SzymonWarmiak/uec_projekt_wireless_camera_transfer/doc/raport_warmiak_twardosz_2026.docx

# Tytuł: Bezprzewodowy System Transmisji Wideo i Sterowania

# Autorzy: Szymon Warmiak (SW), Grzegorz Twardosz (GT)

Ostatnia modyfikacja: 12.06.2026

Spis treści

1. Repozytorium git 1

2. Wstęp 1

3. Specyfikacja 1

3.1. Opis ogólny algorytmu 1

3.2. Tabela zdarzeń 2

4. Architektura 2

4.1. Moduł: top 2

4.1.1. Schemat blokowy 2

4.1.2. Porty 3

a) mou – mouse_ctl, input 3

b) vga – vga_ctl, output 3

4.1.3. Interfejsy 3

a) m2c – mouse_ctl to core 3

4.2. Rozprowadzenie sygnału zegara 3

5. Implementacja 4

5.1. Lista zignorowanych ostrzeżeń Vivado. 4

5.2. Wykorzystanie zasobów 4

5.3. Marginesy czasowe 4

6. Film. 4

# 1. Repozytorium git

Adres repozytorium GITa:

https://github.com/SzymonWarmiak/FPGA-Wireless-Rover

# 2. Wstęp

Celem tego projektu było wykonanie zdalnie sterowanej mobilnej platformy jeżdżącej wyposażonej w kamerę OV7670 która przesyła odebrany obraz z powrotem do stacji bazowe z wyjściem VGA.
Pomysł zrodził się z chęci połączenia zagadnień przetwarzania obrazu w czasie rzeczywistym na FPGA z komunikacją bezprzewodową Wi-Fi. System wykorzystuje dwie płytki Basys 3 połączone radiowo przez mikrokontrolery ESP32, realizując transmisję obrazu z kamery OV7670 w rozdzielczości 320×240 pikseli w skali szarości. Dodatkowo zaimplementowano zdalne sterowanie platformą jezdną (mostek H L298N) z dedykowanej aplikacji mobilnej (Android) oraz desktopowej (Windows/Python).

# 3. Specyfikacja

## 3.1. Opis ogólny algorytmu

## 1. Po włączeniu zasilania moduł MMCME2_BASE generuje zegary 40 MHz (system) i 65 MHz (VGA)..

## 2. Konfigurator (ov7670_configurator) programuje 55 rejestrów kamery OV7670.

## 3. Moduł ov7670_capture przechwytuje klatki RGB565, wyciąga luminancję (kanał zielony), wykonuje downsampling 2× do rozdzielczości 320×240 i generuje strumień AXI-Stream.

## 4. Piksele przechodzą przez asynchroniczne FIFO z domeny pclk kamery do domeny systemowej 40 MHz.

## 5. Maszyna stanów (WAIT_FRAME → SEND_PIXELS → SEND_CTRL) w top.sv kieruje strumień do modułu spi_stream_master, który wysyła 76 800 bajtów przez SPI z zegarem 20 MHz do ESP32.

## 6. ESP32 (cam) fragmentuje klatkę na 75 pakietów UDP po 1027 B i transmituje bezprzewodowo do ESP32 (station).

## 7. ESP32 (station) składa pakiety i udostępnia je przez SPI slave.

## 8. FPGA stacji (spi_stream_rx) odpytuje ESP32 wysyłając marker 0xCAFE i odbiera 76 800 B klatki, zapisując ją do dual-port BRAM.

## 9. Renderer VGA (vga_frame_renderer) odczytuje BRAM i wykonuje obrót o 90° oraz skalowanie ×2.13, wyświetlając obraz w standardzie XGA 1024×768 @ 60 Hz.

- Komendy sterujące (4-bitowy nibble) wysyłane z aplikacji mobilnej (Android/Windows)

przez UDP do ESP32 (cam), który przekazuje je po SPI MISO z powrotem do FPGA kamery.

Moduł motor_l298n_decode dekoduje nibble na sygnały IN1-IN4 mostka H silników L298N.

## 3.2. Tabela zdarzeń

Opis zdarzeń występujących podczas działania programu/urządzenia, zarówno zewnętrznych (interakcje z użytkownikiem), jak i wewnętrznych (specyficzne stany w algorytmie). Zdarzenia podzielone są na kategorie dotyczące różnych stanów działania programu. Kategorie powinny odpowiadać stanom ze schematu z pkt. 2.1.

Zdarzenie | Kategoria | Reakcja systemu
Naciśnięcie btnC | Reset | Asynchroniczny reset wszystkich modułów
Koniec konfiguracji SCCB | Inicjalizacja | Kamera generuje klatki (done=1)
vsync z kamery | Przechwytywanie | Zerowanie liczników, ustawienie flagi SOF
fifo_tuser=1 (SOF) | Transmisja | FSM przechodzi z WAIT_FRAME do SEND_PIXELS
spi_tlast=1 | Transmisja | Koniec klatki SPI, FSM wraca do WAIT_FRAME
Marker 0xCAFE odebrany | Odbiór (station) | ESP32 potwierdza połączenie, wysyła klatkę
Komenda UDP z aplikacji | Sterowanie | Nibble przekazywany do motor_l298n_decode
Sprzeczne komendy (góra+dół) | Sterowanie | motor_l298n_decode wymusza MOT_STOP

# 4. Architektura

Uwaga: dobrze zrobiony projekt zawiera tylko moduły strukturalne (zbudowane z innych modułów) i funkcjonalne (zawierające bloki proceduralne always @). Staramy się nie generować bloków mieszających te dwa typy, o ile to możliwe (głównym kryterium powinna być czytelność kodu).

Uwaga: opisujemy architekturę tylko głównego modułu oraz rozprowadzenie sygnału zegara.

## 4.1. Moduł: top

Osoba odpowiedzialna: JK

### 4.1.1. Schemat blokowy

Uwaga: Schemat blokowy to nie jest schemat z Vivado! Nie zawiera on sygnałów, tylko interfejsy. Interfejs oznacza tutaj grupę sygnałów. Schemat blokowy pokazuje moduły składowe, oraz łączące je interfejsy.

Miejsce na schemat blokowy modułu głównego

Uwaga:

- interfejsy dwukierunkowe rozbijamy na 2 interfejsy jednokierunkowe
- nazwa interfejsu stanowi prefiks nazwy sygnałów składowych
- w interfejsach nie uwzględniamy sygnałów globalnych (np. clk i rst).

### 4.1.2. Porty

#### a) mou – mouse_ctl, input

nazwa portu | opis
mou_si | szeregowe wejście danych

#### b) vga – vga_ctl, output

nazwa portu | opis
vga_vs | sygnał synchronizacji pionowej VGA

### 4.1.3. Interfejsy

#### a) m2c – mouse_ctl to core

nazwa sygnału | opis
m2c_x[9:0] | horyzontalna pozycja kursora myszy na ekranie
m2c_y[9:0] | wertykalna pozycja kursora myszy na ekranie

## 4.2. Rozprowadzenie sygnału zegara

Osoba odpowiedzialna: JK

Informacja na temat źródła sygnału zegarowego, używanych częstotliwości zegara w całym układzie.

Moduł generatora zegara umieszczamy w module głównym projektu. W pozostałych modułach używamy tylko i wyłącznie sygnały zegara wygenerowane przez ten moduł.

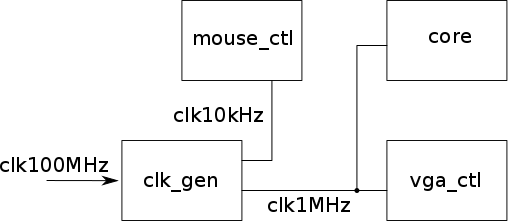
[picture p10: figure]

Uwaga: jeżeli używamy różnych częstotliwości zegara w układzie, to należy je tak dobrać, aby były wielokrotnościami siebie (umożliwia to wygenerowanie tych sygnałów z jednego IP core generatora zegara i zapobiega problemom z synchronizacją).

# 5. Implementacja

## 5.1. Lista zignorowanych ostrzeżeń Vivado.

Identyfikator ostrzeżenia | Liczba wystąpień | Uzasadnienie

## 5.2. Wykorzystanie zasobów

Tabela z wykorzystaniem zasobów z Vivado

## 5.3. Marginesy czasowe

Marginesy czasowe (WNS) dla setup i hold.

# 6. Konfiguracja sprzętu

Schemat połączenia ze sobą płytek Basys3 w trybie multiplayer.

Schematy podłączenia dodatkowych urządzeń peryferyjnych.

Konfiguracja zworek, przełączników, itp., jeśli inna niż domyślna.

# 7. Film.

Link do ściągnięcia filmu:

https://

MTM UEC2 12.06.2026 Raport z projektu, v.1.0.1 4 / 4
