SzymonWarmiak/uec_projekt_wireless_camera_transfer/tools/README.md

# Narzędzia projektowe (Tools)

Ten folder zawiera uniwersalne skrypty wspierające pracę z wieloma układami w projekcie (w tym automatyzację wgrywania kodu na konkretne płytki FPGA).

## 1. Wgrywanie Bitstreamu na FPGA (`program_basys.sh`)

Skrypt `program_basys.sh` pozwala na wgranie wygenerowanego strumienia bitów (`.bit`) na docelową płytkę Basys 3. Skrypt został zintegrowany z plikiem konfiguracyjnym, dzięki czemu nie trzeba pamiętać długich sprzętowych numerów JTAG.
Po wgraniu `.bit` skrypt programuje też lokalną pamięć QSPI plikiem `.bin`, dzięki czemu FPGA odtworzy konfigurację po ponownym włączeniu zasilania.

### Jak tego używać?
Będąc w **głównym katalogu** projektu wpisz komendę z dwoma argumentami:
1. Nazwę folderu modułu (np. `basys_cam` lub `basys_station`).
2. Przyjazną nazwę płytki zdefiniowaną w pliku `board_config.sh` (np. `basys15`).

```bash
./tools/program_basys.sh basys_cam basys15
```
*Powyższa komenda odnajdzie pliki `.bit` i `.bin` w `basys_cam/results/`, wypisze ich daty wygenerowania, zaprogramuje FPGA oraz pamięć QSPI płytki "basys15".*

### Co jeśli mam tylko jedną płytkę?
Jeśli masz podłączoną tylko jedną płytkę, możesz pominąć drugi argument. Vivado wgra projekt na pierwsze urządzenie, jakie znajdzie:
```bash
./tools/program_basys.sh basys_station
```

### Pamięć QSPI

Skrypt próbuje zaprogramować pamięć QSPI automatycznie, sprawdzając obsługiwane typy pamięci po kolei. Po poprawnym zapisie ustaw zworkę `JP1` w pozycję `QSPI`, żeby FPGA startowało z pamięci po włączeniu zasilania.

---

## 2. Zarządzanie przypisaniami (`board_config.sh`)

W pliku `board_config.sh` znajduje się mapa przyjaznych nazw przypisana do identyfikatorów JTAG (Target ID). 
Jeśli w przyszłości otrzymasz inną płytkę z laboratorium, wystarczy odczytać jej numer i zaktualizować ten plik.

Format wpisów to `BOARD_<twoja_nazwa>="<jtag_id>"`.

---

## 3. Listowanie podłączonych układów FPGA (`list_basys_devices.sh`)

Jeśli potrzebujesz sprawdzić sprzętowe numery JTAG aktualnie podłączonych urządzeń, użyj komendy:
```bash
./tools/list_basys_devices.sh
```
