SzymonWarmiak/uec_projekt_wireless_camera_transfer/(commit log)

2026-05-14 first fix, delete old things, to check
    [spi_slave.cpp, spi_stream_rx.sv, top.sv]
2026-05-28 refactor: rename targets to role-based names + add bitstream/qspi scripts
    - basys_1 -> basys_cam, basys_2 -> basys_station (git mv, historia zachowana)
    - main_esp1.cpp -> main_cam.cpp, main_esp2.cpp -> main_station.cpp
    - tools/generate_bitstream_basys.sh: wrapper sourcujacy env.sh + generate_bitstream.sh modulu, do uruchamiania z roota
    - tools/program_qspi_basys.sh + .tcl: trwale programowanie flash S25FL032P na Basys 3 (pelny cykl: write_cfgmem MCS, program_hw_cfgmem, verify)
    - README, tools/README i przyklady w skryptach: nowe nazwy
    - spi_slave.cpp: komentarz wskazuje teraz basys_cam/rtl/top.sv
    - usuniete: zagniezdzone .git w basys_1 i basys_2 (powodowaly problemy z renamem), smieci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
    [main_cam.cpp, main_station.cpp, ov7670_capture.sv, ov7670_configurator.sv, spi_slave.cpp, spi_stream_master.sv, spi_stream_rx.sv, top.sv]
2026-05-28 Improve station video path and RTL cleanup on control-bus branch. Remove unused RTL, add debounced buttons on station, fix ESP32 SPI (CTRL/FRAME split, safe RX buffer) for stable full-frame streaming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
    [debounce.sv, main_cam.cpp, main_station.cpp, ov7670_configurator.sv, spi_stream_master.sv, spi_stream_rx.sv, top.sv, vga_frame_renderer.sv]
2026-05-30 Sterowanie L298N z pada, UART/JXADC, wideo UDP bez Dabble. - basys_cam: uart_ctrl_bridge, motor_l298n_decode, JXADC 7-10, README/docs - ESP main_cam: SPI + UART do FPGA, UDP start/stop i nibble kieru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
2026-06-01 spi modification
